moorendev/Group15/README.md

# Group15
The repository for group 15 of INFR 3380U - Industrial Design for Game Hardware

Members:

synomint - Nathaniel Moore 100785826

dym99 - Dylan Moore 100662175
