moorendev/Group15/(list of files, cad)

Other CAD files:
CAD/Joystick Assembly v10.f3z
