moorendev/Group15/CAD/Technical Drawings.pdf

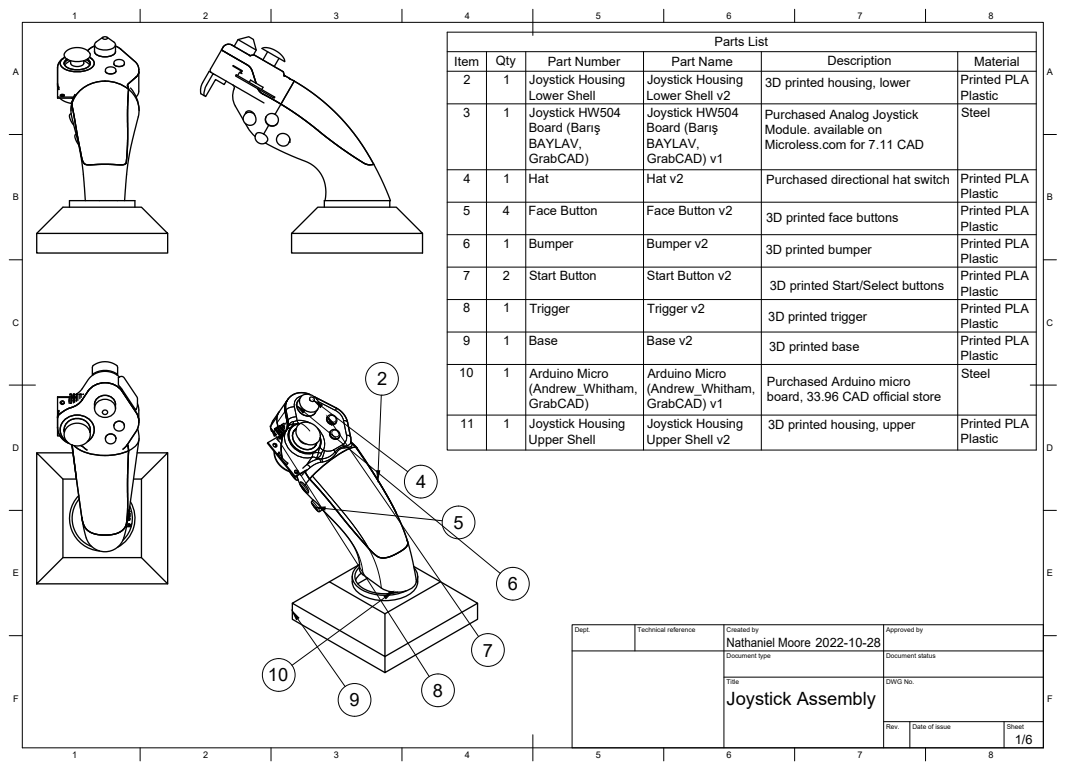
[picture p4: page 1]
8 BCDEF; ABCDEF; Title; DWG No.; Rev.; Date of issue; Sheet; Joystick Assembly; Parts List; Plastic 9

Item | Qty 1 | Joystick Housing Part Number | Part Name | Description | Material 2
1 | Lower Shell Joystick HW504 | Joystick Housing Lower Shell v2 | 3D printed housing, lower | Printed PLA Plastic 3

1 | Hat Board (Barış BAYLAV, GrabCAD) | Hat v2 Joystick HW504 Board (Barış BAYLAV, GrabCAD) v1 | Purchased Analog Joystick Module. available on Microless.com for 7.11 CAD | Printed PLA Steel 4

4 | Face Button | Face Button v2 | Purchased directional hat switch | Plastic 5 Printed PLA

1 | Bumper | Bumper v2 | 3D printed face buttons | Plastic 6 Printed PLA

2 | Start Button | Start Button v2 | 3D printed bumper | Plastic 7 Printed PLA

1 | Trigger | Trigger v2 | 3D printed Start/Select buttons | Plastic 8 Printed PLA

1 | Base | Base v2 | 3D printed trigger | Plastic 9 Printed PLA

3D printed base | Plastic

10 | 1 | Arduino Micro (Andrew_Whitham, GrabCAD) | Arduino Micro (Andrew_Whitham, GrabCAD) v1 | Purchased Arduino micro board, 33.96 CAD official store | Steel

11 | 1 | Joystick Housing Upper Shell | Joystick Housing Upper Shell v2 | 3D printed housing, upper | Printed PLA

Dept. | Technical reference | Created by Nathaniel Moore 2022-10-28 | Approved by

Document type | Document status

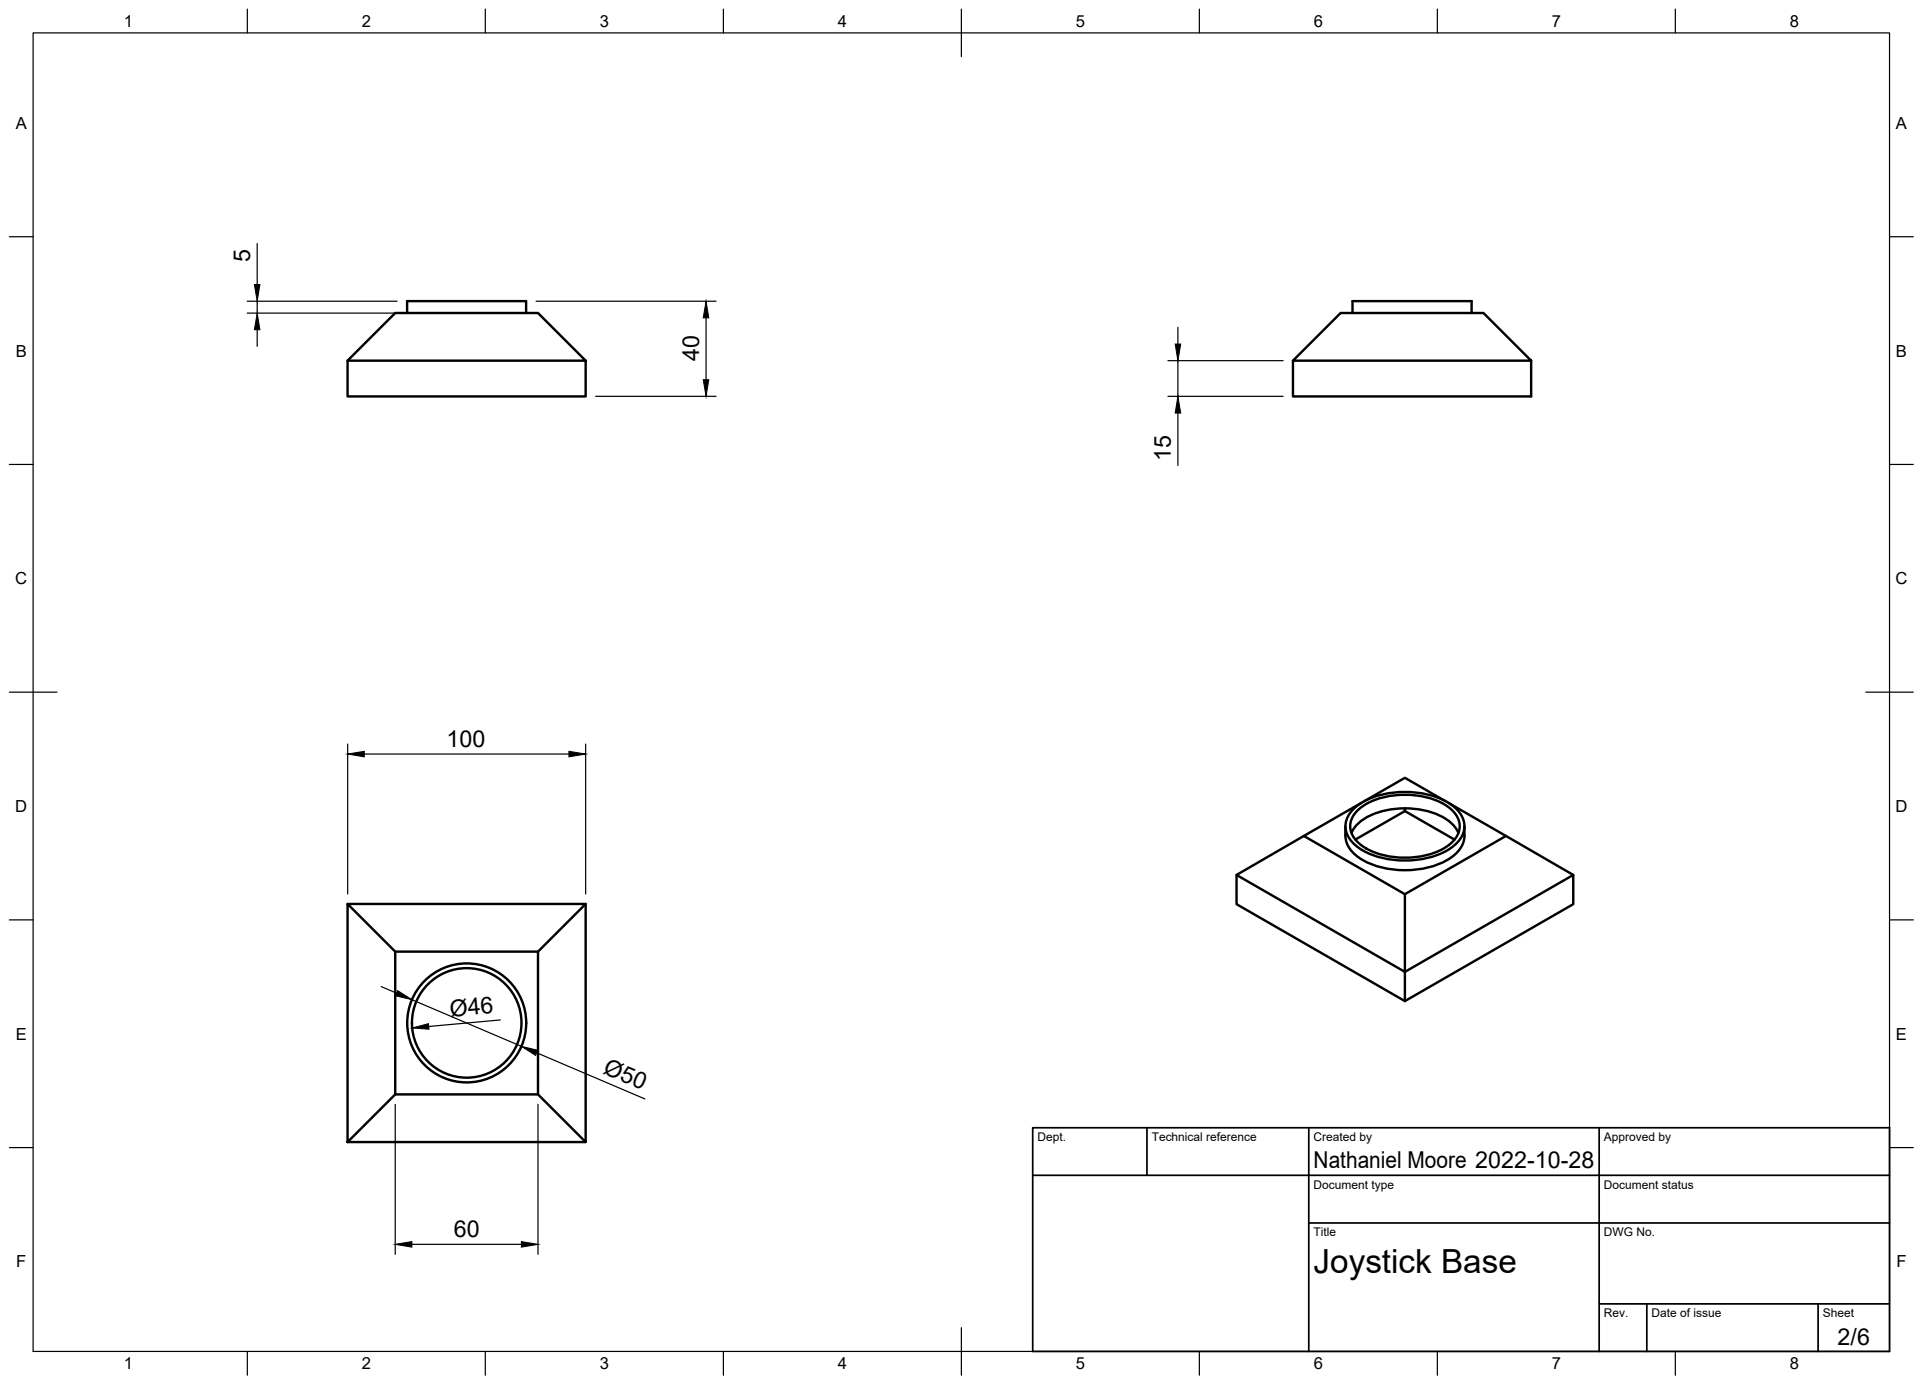
[picture p5: page 2]
Title; DWG No.; Joystick Base

Dept. | Technical reference | Created by Nathaniel Moore 2022-10-28 | Approved by

Document type | Document status

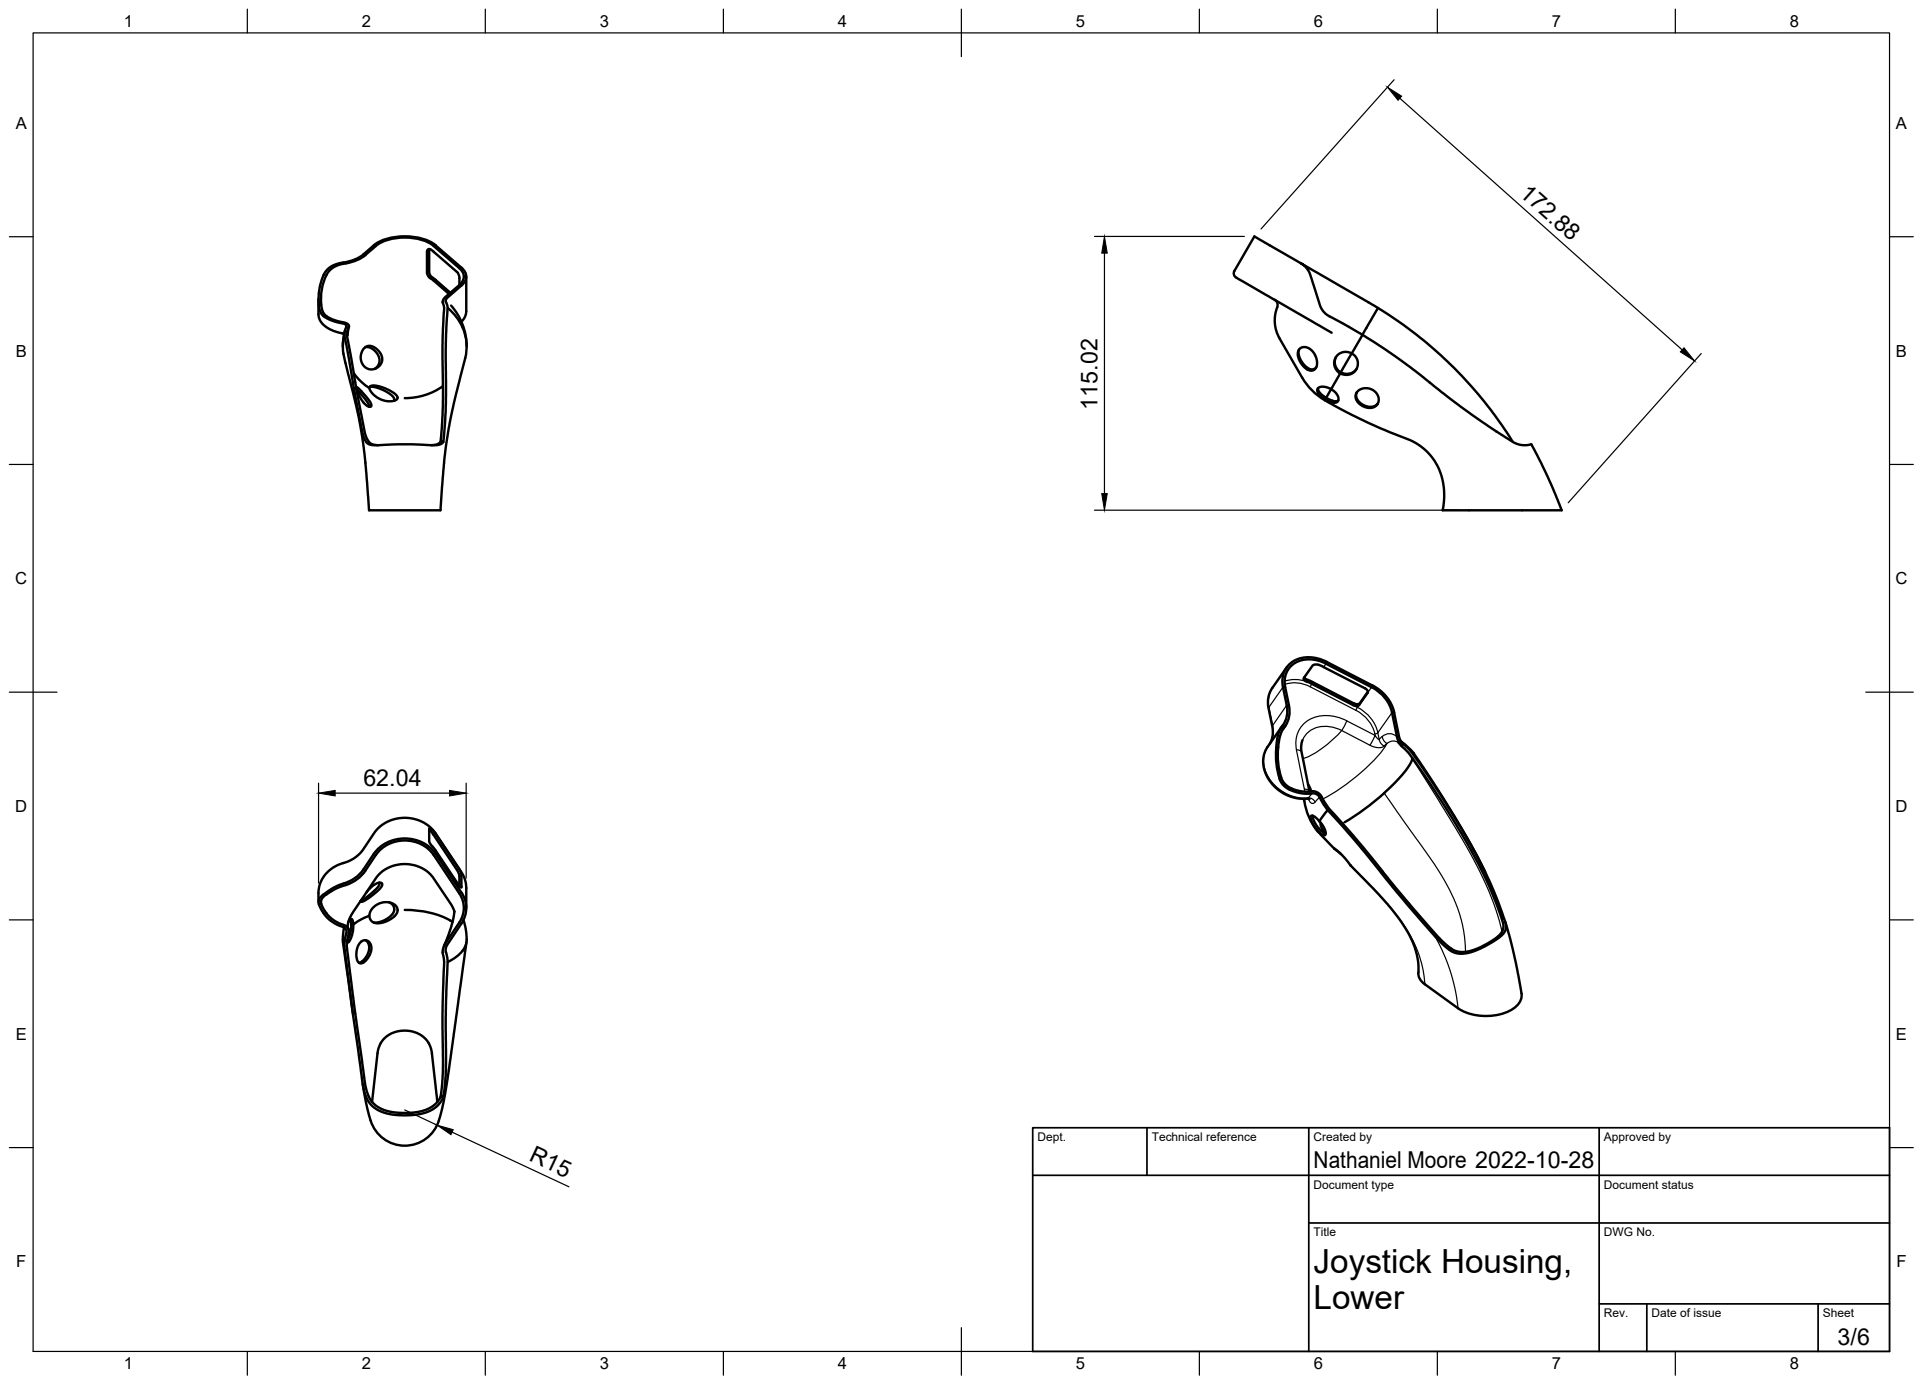
[picture p6: page 3]
Title; DWG No.; Joystick Housing,; R15 Nathaniel Moore

Dept. | Technical reference | Created by 2022-10-28 | Approved by

Document type | Document status

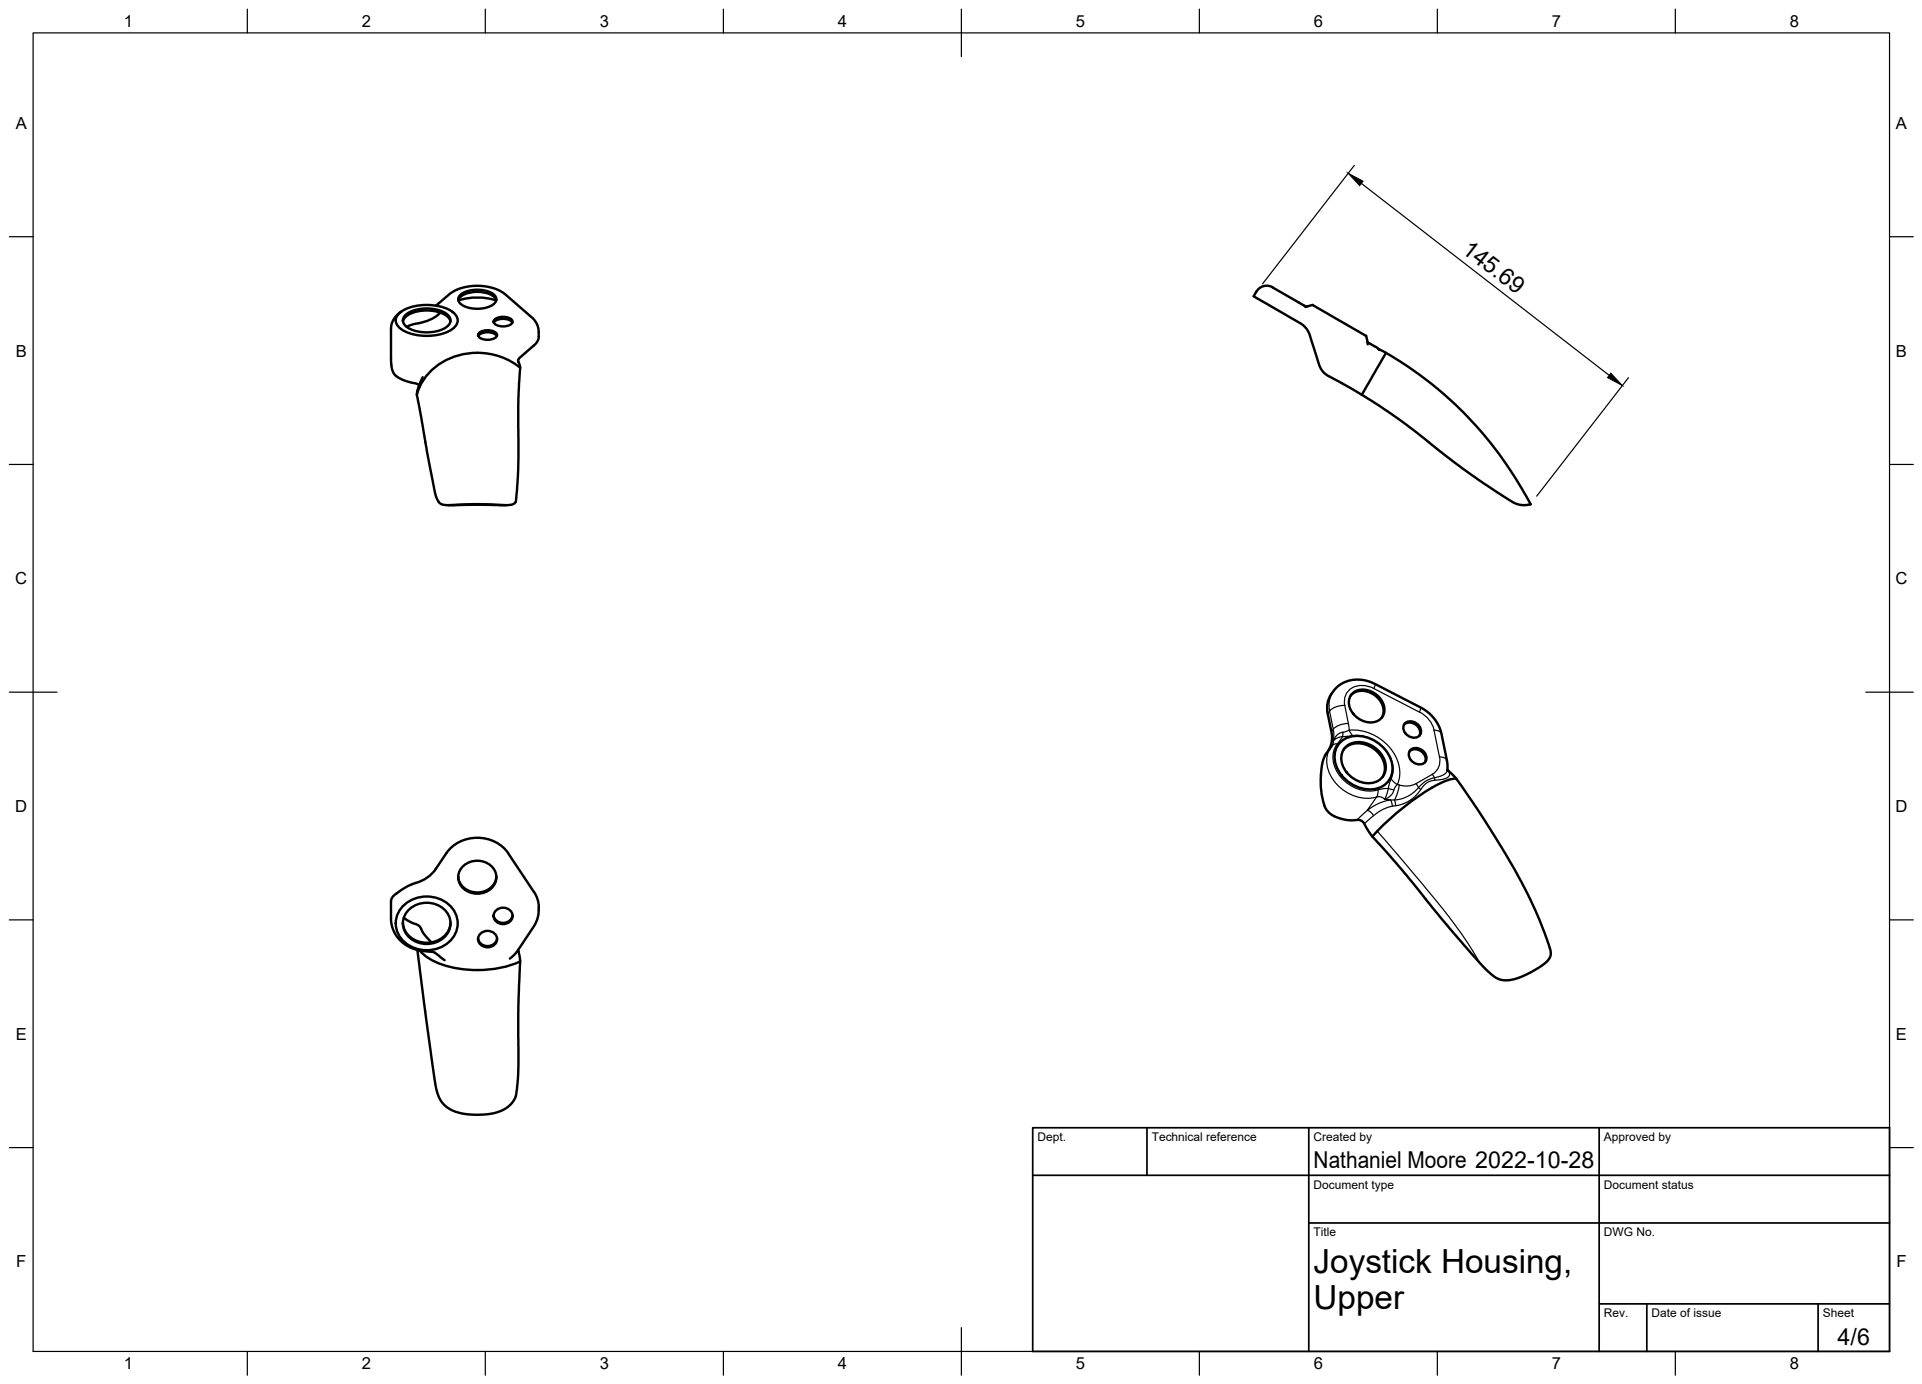
[picture p7: page 4]
Title; DWG No.; Joystick Housing,

Dept. | Technical reference | Created by Nathaniel Moore 2022-10-28 | Approved by

Document type | Document status

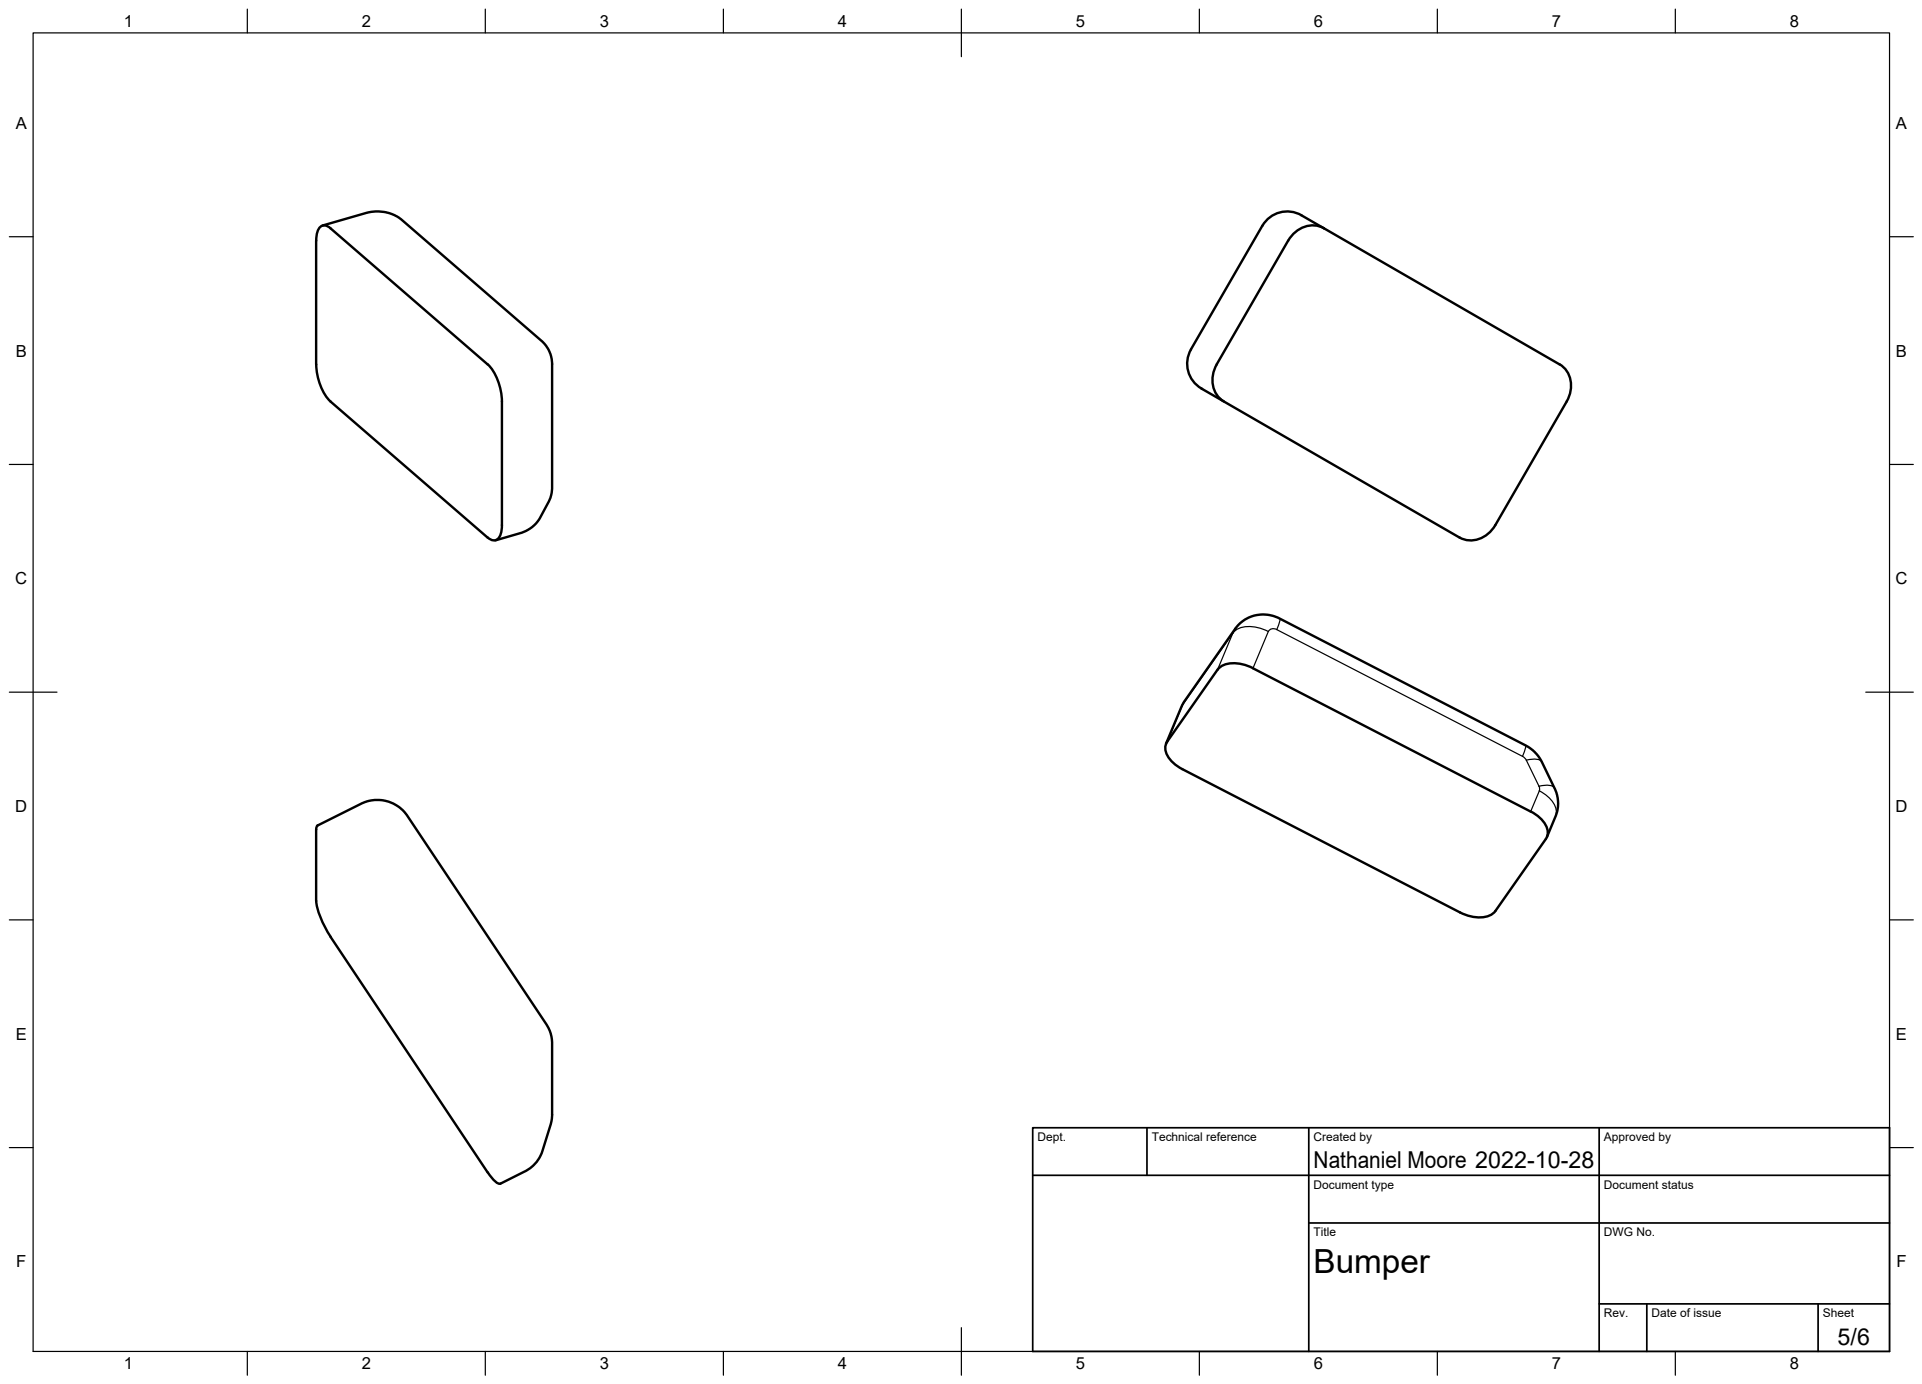
[picture p8: page 5]
Title; DWG No.

Dept. | Technical reference | Created by Nathaniel Moore 2022-10-28 | Approved by

Document type | Document status

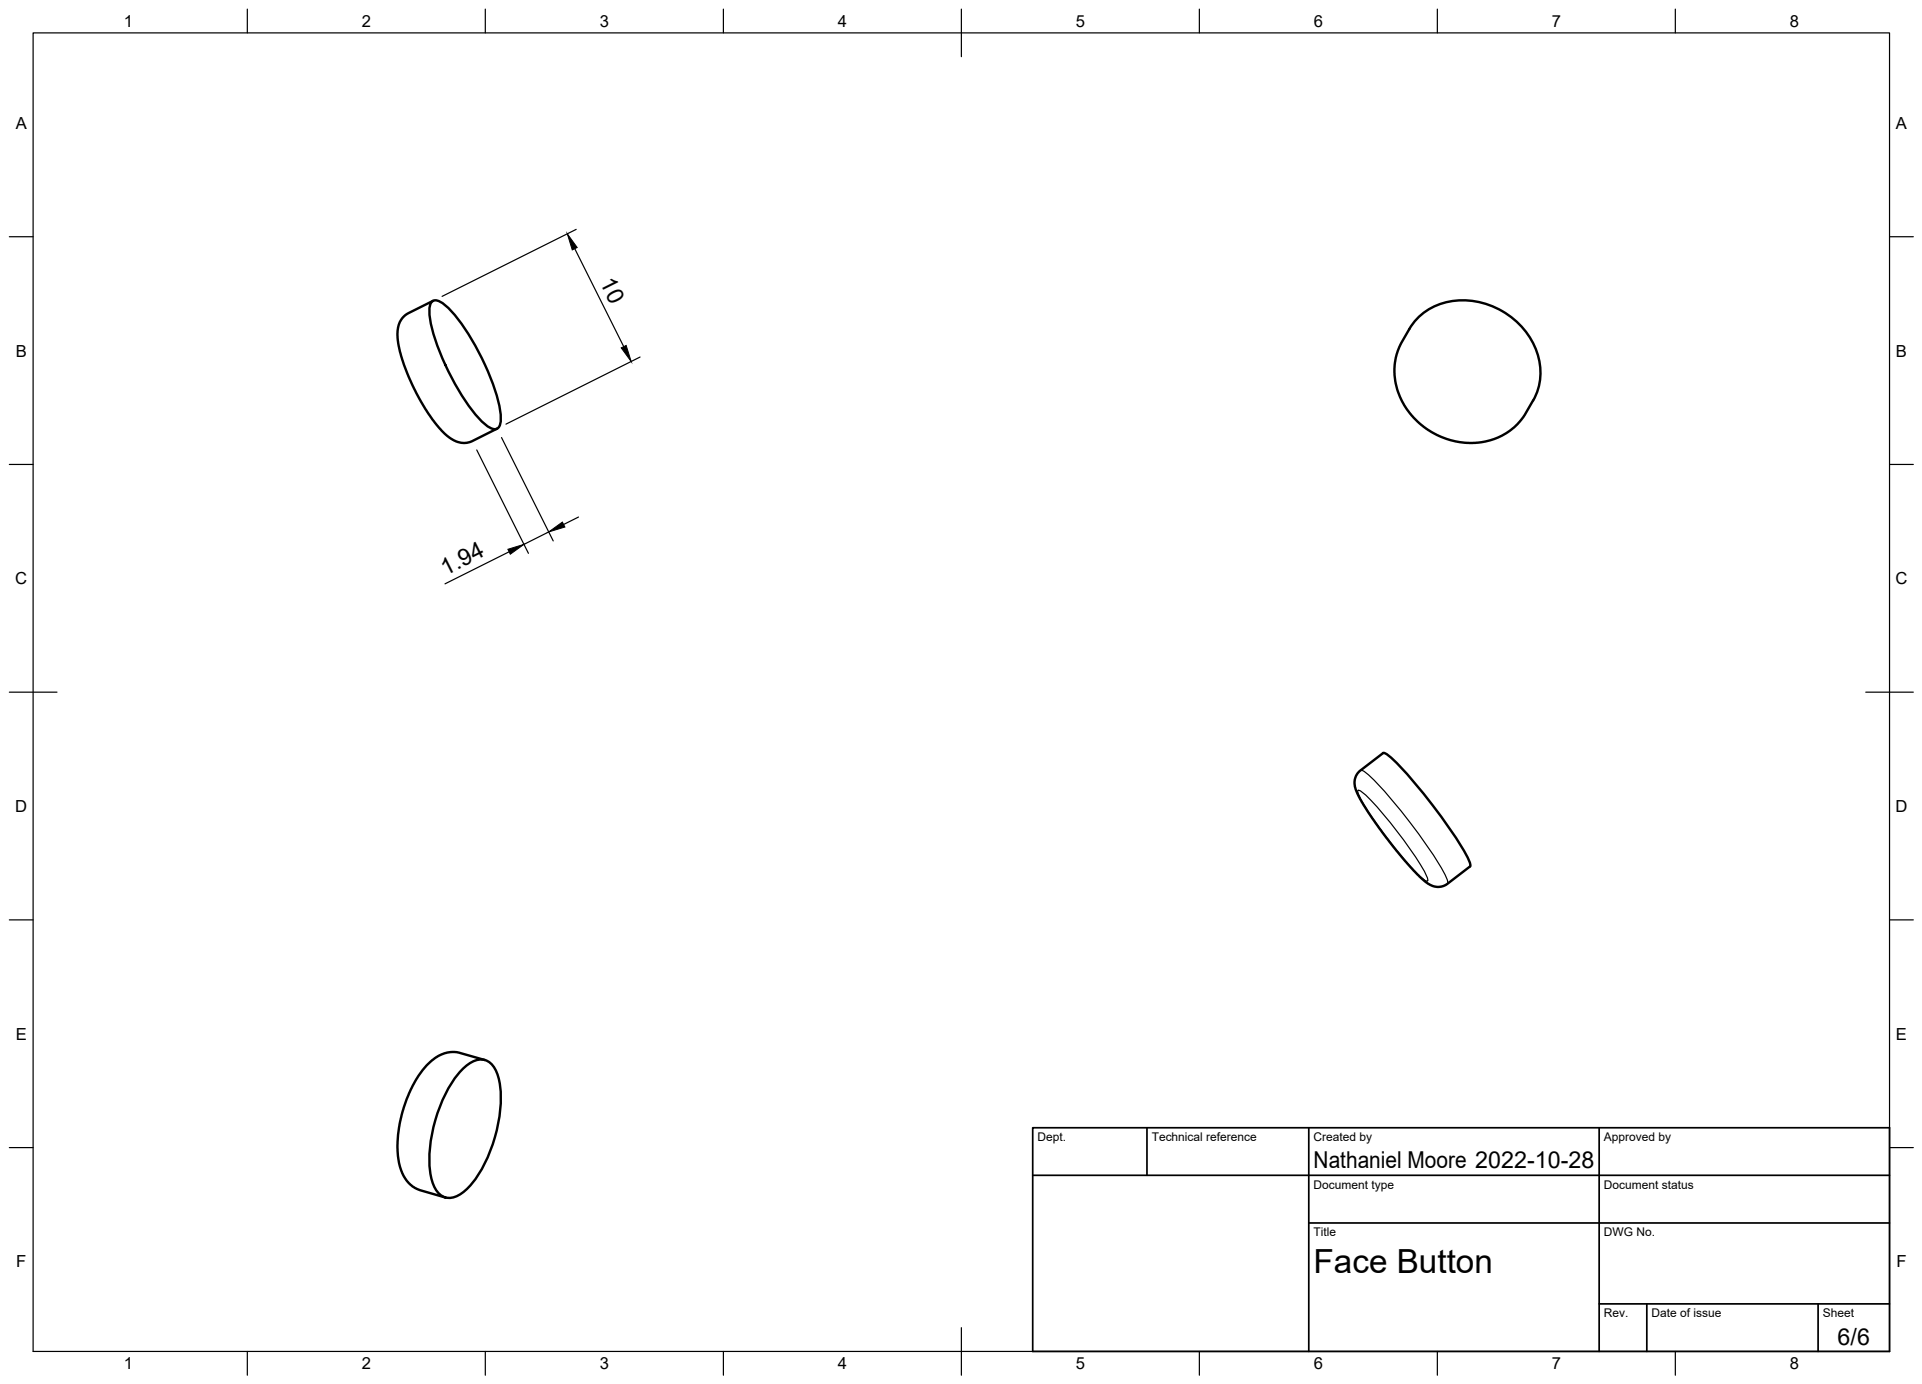
[picture p9: page 6]
Title; DWG No.; Face Button

Dept. | Technical reference | Created by Nathaniel Moore 2022-10-28 | Approved by

Document type | Document status
