moorendev/Group15/Electronics/ElectronicsSchematic.pdf

# IC1PVDD 8 16 VSS

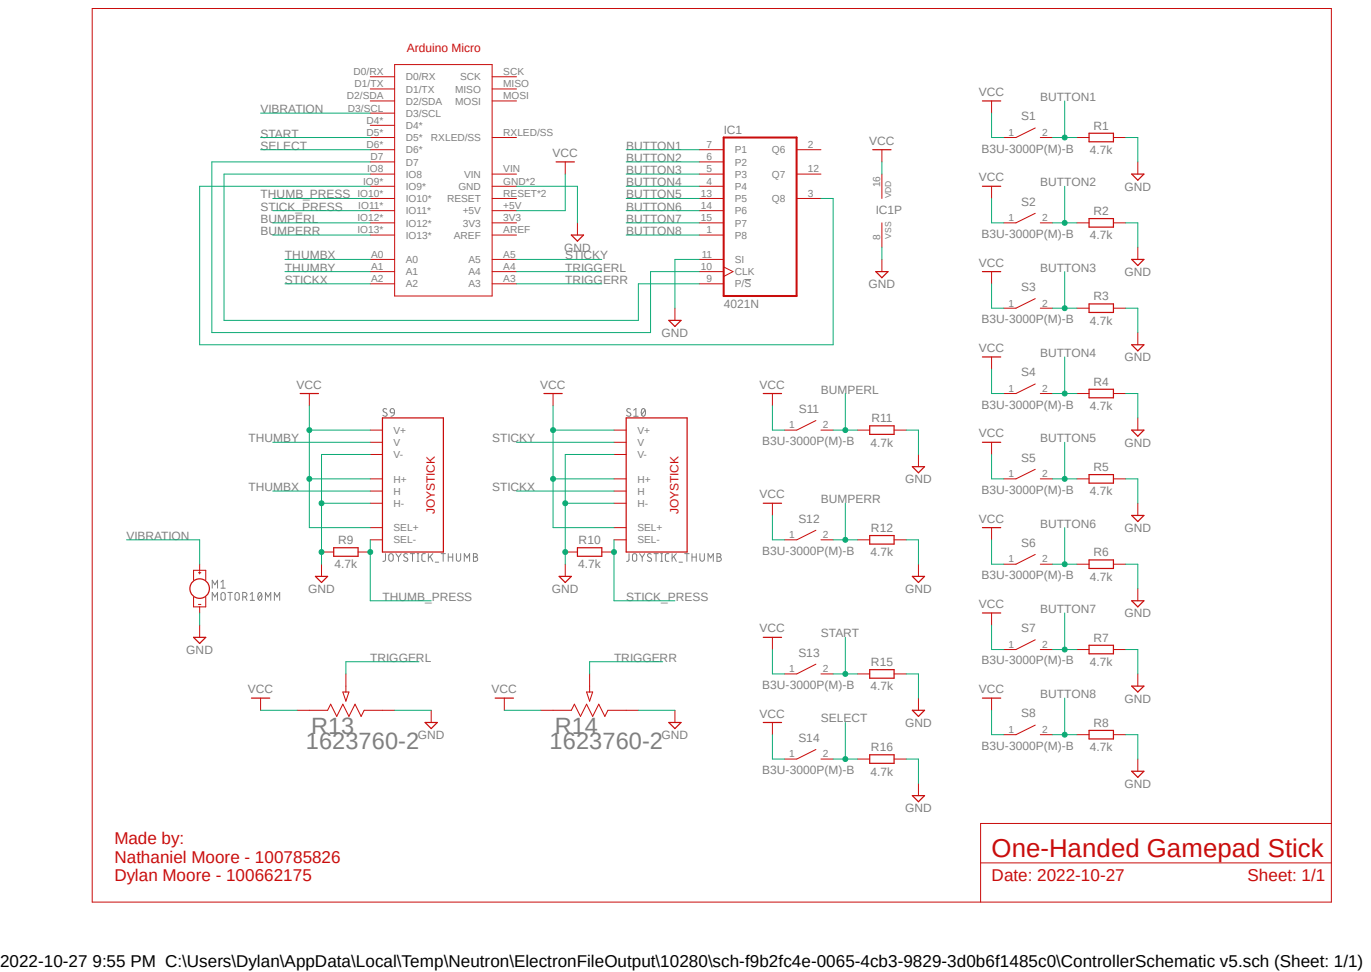
[picture p10: page 1]

One-Handed Gamepad Stick

2022-10-27 9:55 PM C:\Users\Dylan\AppData\Local\Temp\Neutron\ElectronFileOutput\10280\sch-f9b2fc4e-0065-4cb3-9829-3d0b6f1485c0\ControllerSchematic v5.sch (Sheet: 1/1)
