moorendev/Group15/(commit log)

2022-10-28 Add Electronic Schematics
2022-10-28 Add Electronics BOM
    [ControllerSchematicBOM.csv]
2022-10-28 Add Schematic PDF
2022-10-28 Add Electronics Bill of materials
    [ControllerSchematicBOM.csv]
2022-10-28 Add CAD deliverables
    [Joystick Assembly v10.f3z]
